humancomputerintegration/electrotactile-thermal-illusion/Hardware design/PCB.kicad_pcb

## KiCad design Hardware design/PCB.kicad_pcb (2026-09-23)

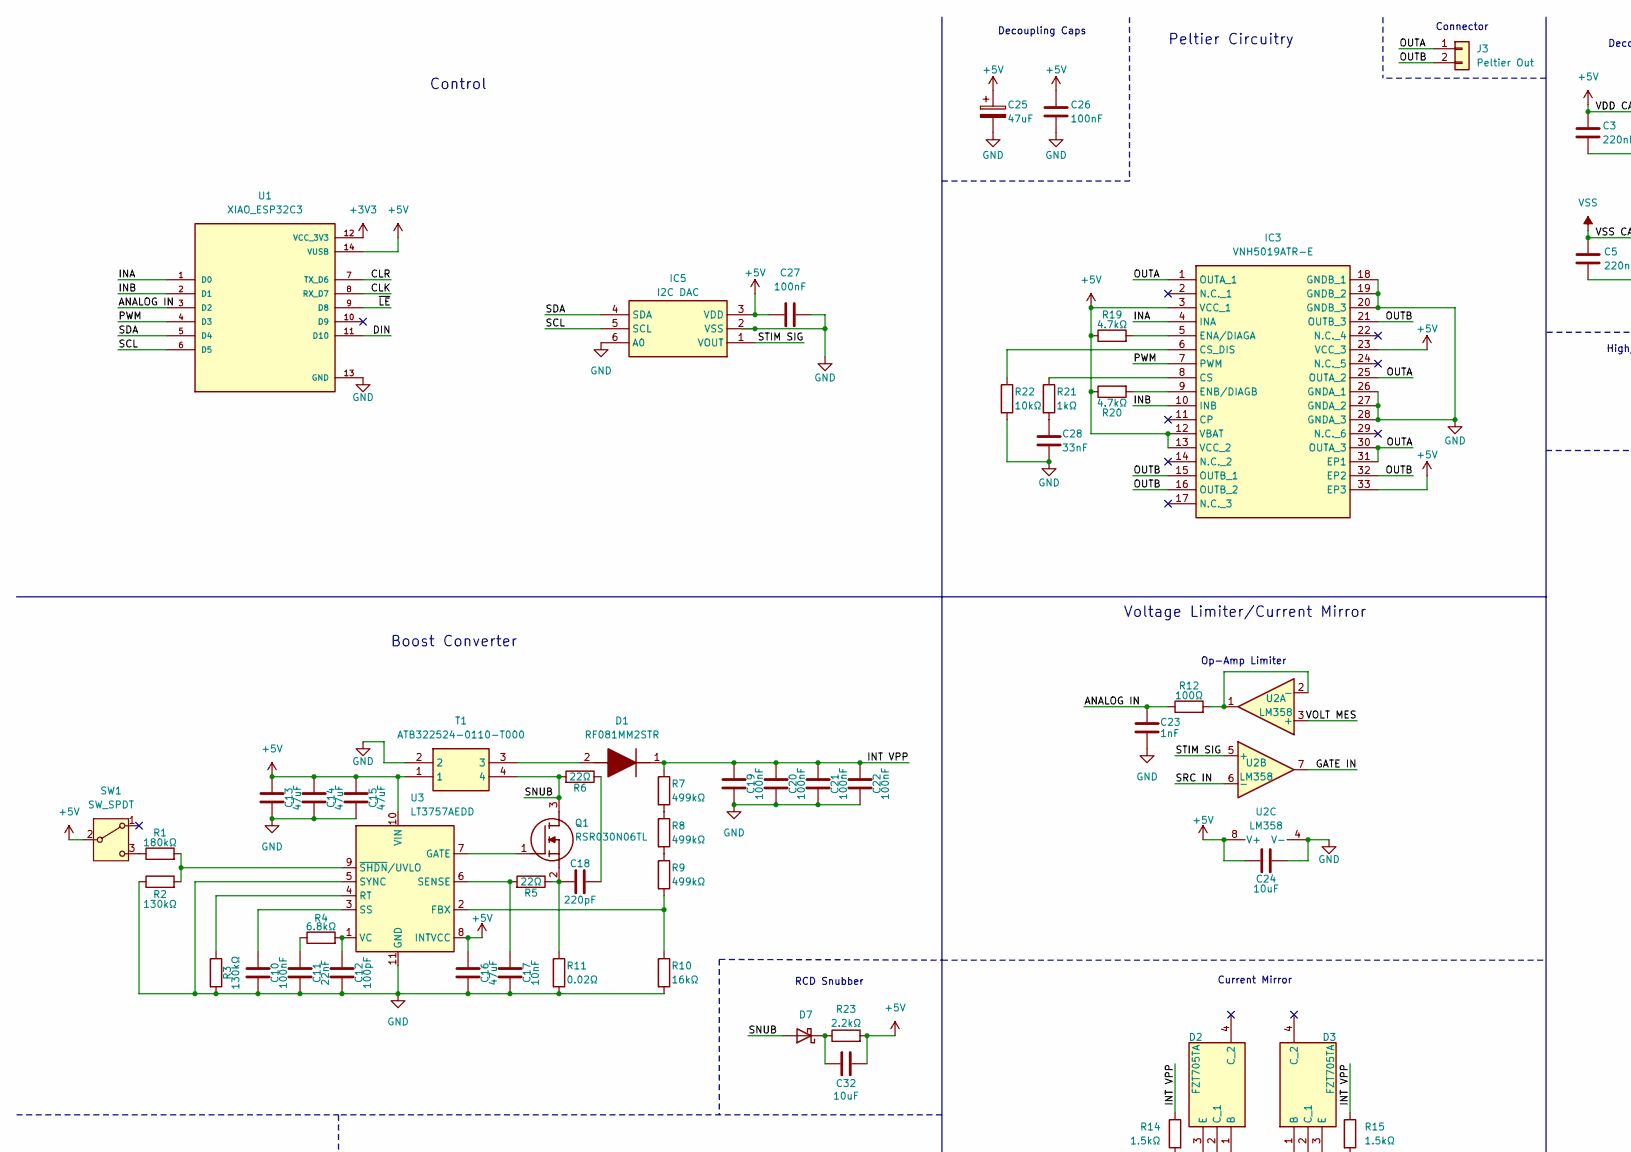
[picture p1: schematic PCB.kicad_sch, part in row 1, column 1]

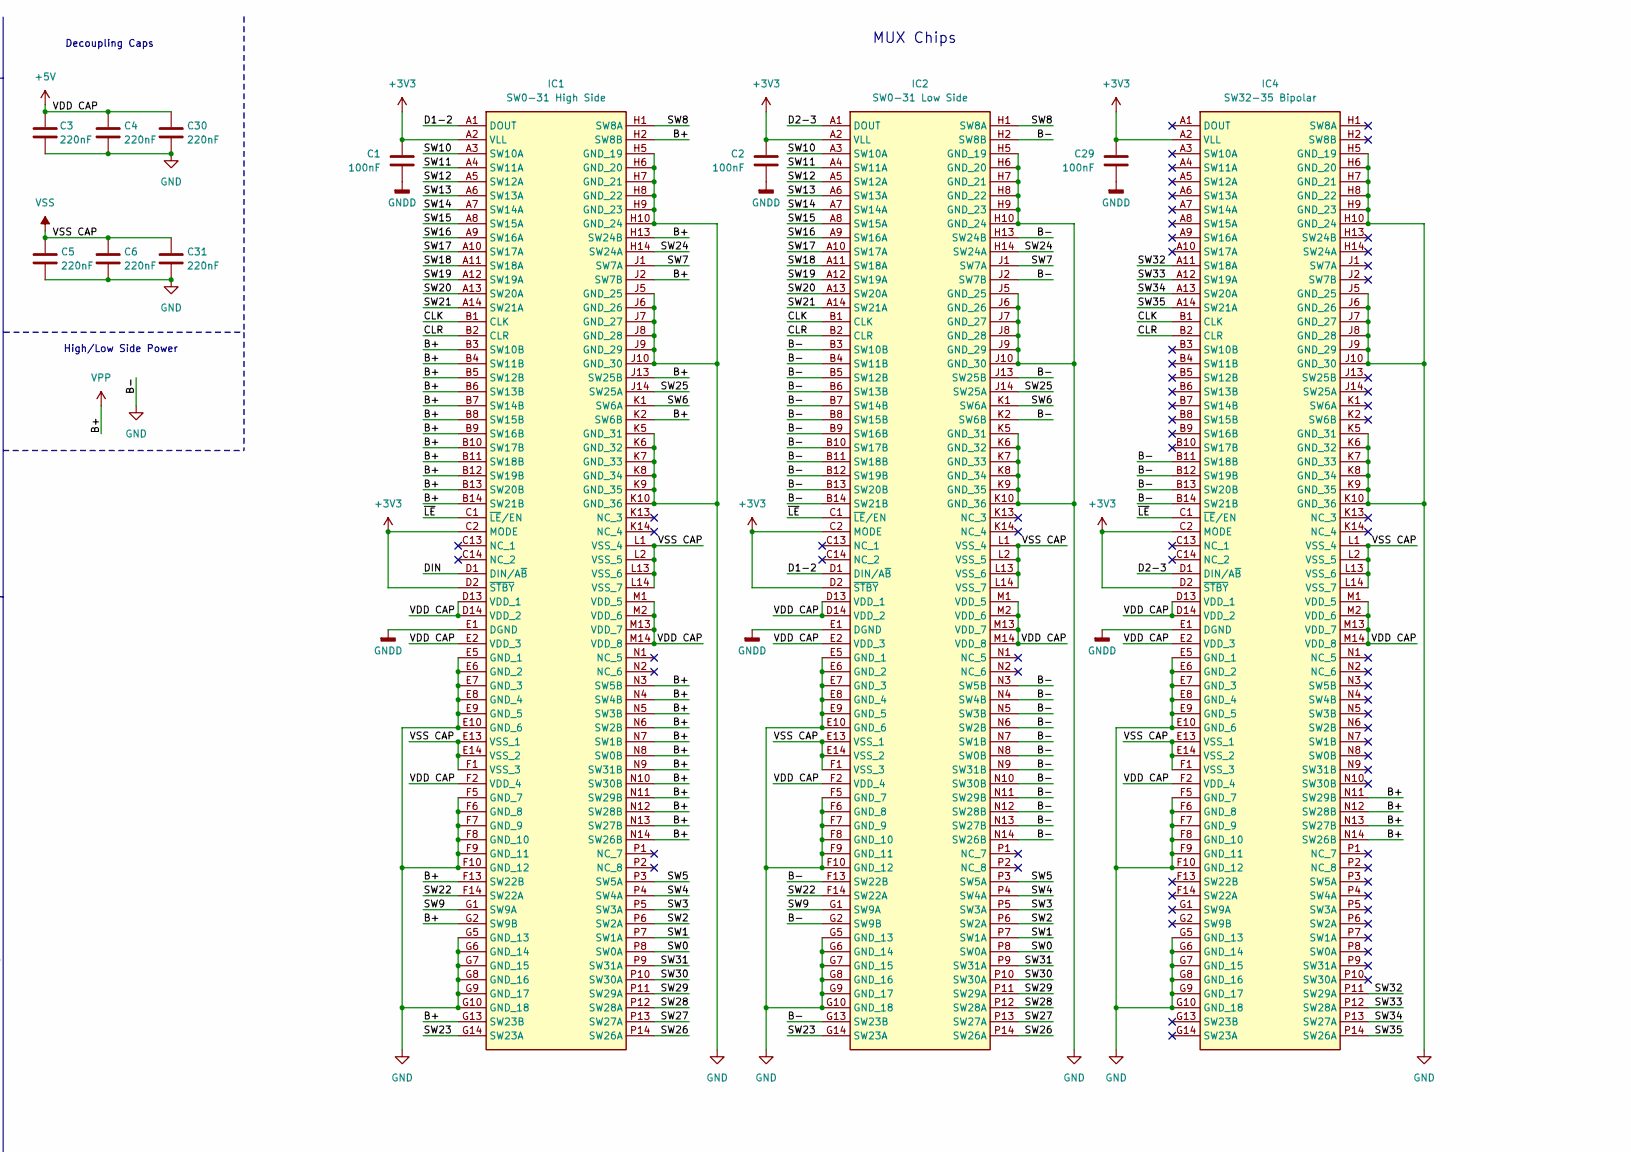
[picture p2: schematic PCB.kicad_sch, part in row 1, column 2]

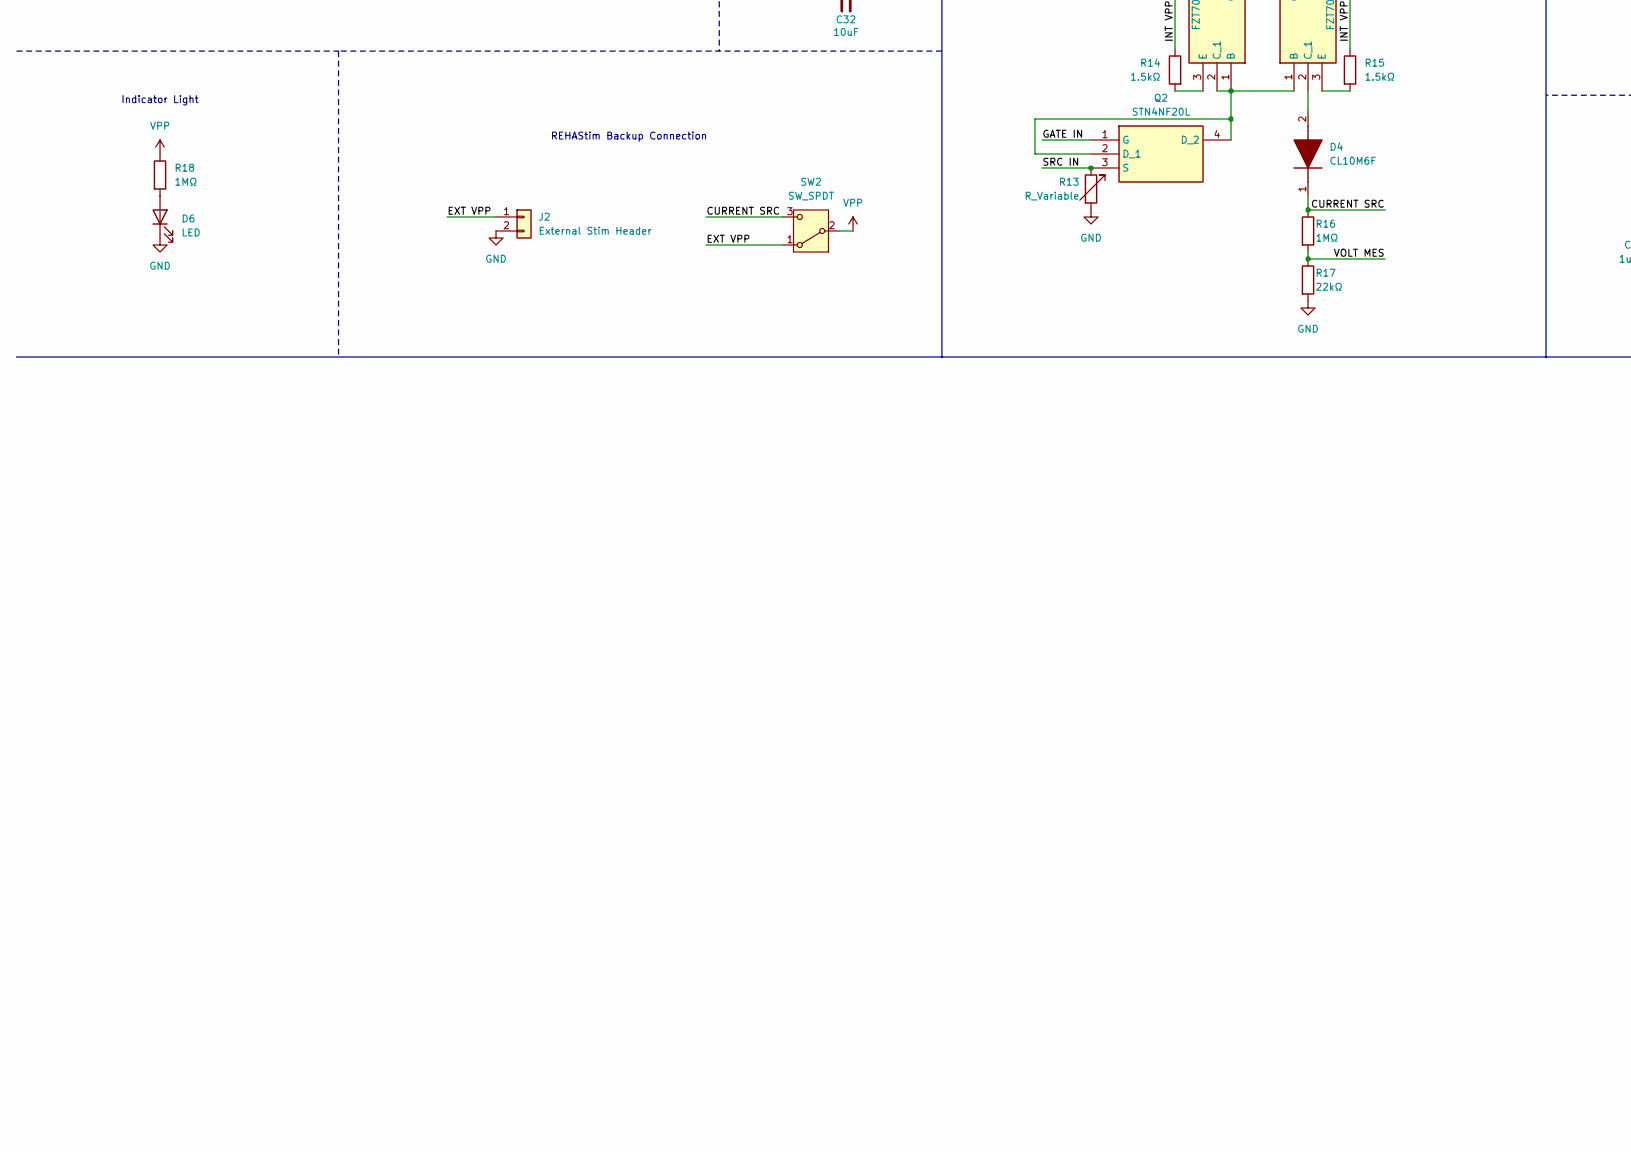
[picture p3: schematic PCB.kicad_sch, part in row 2, column 1]

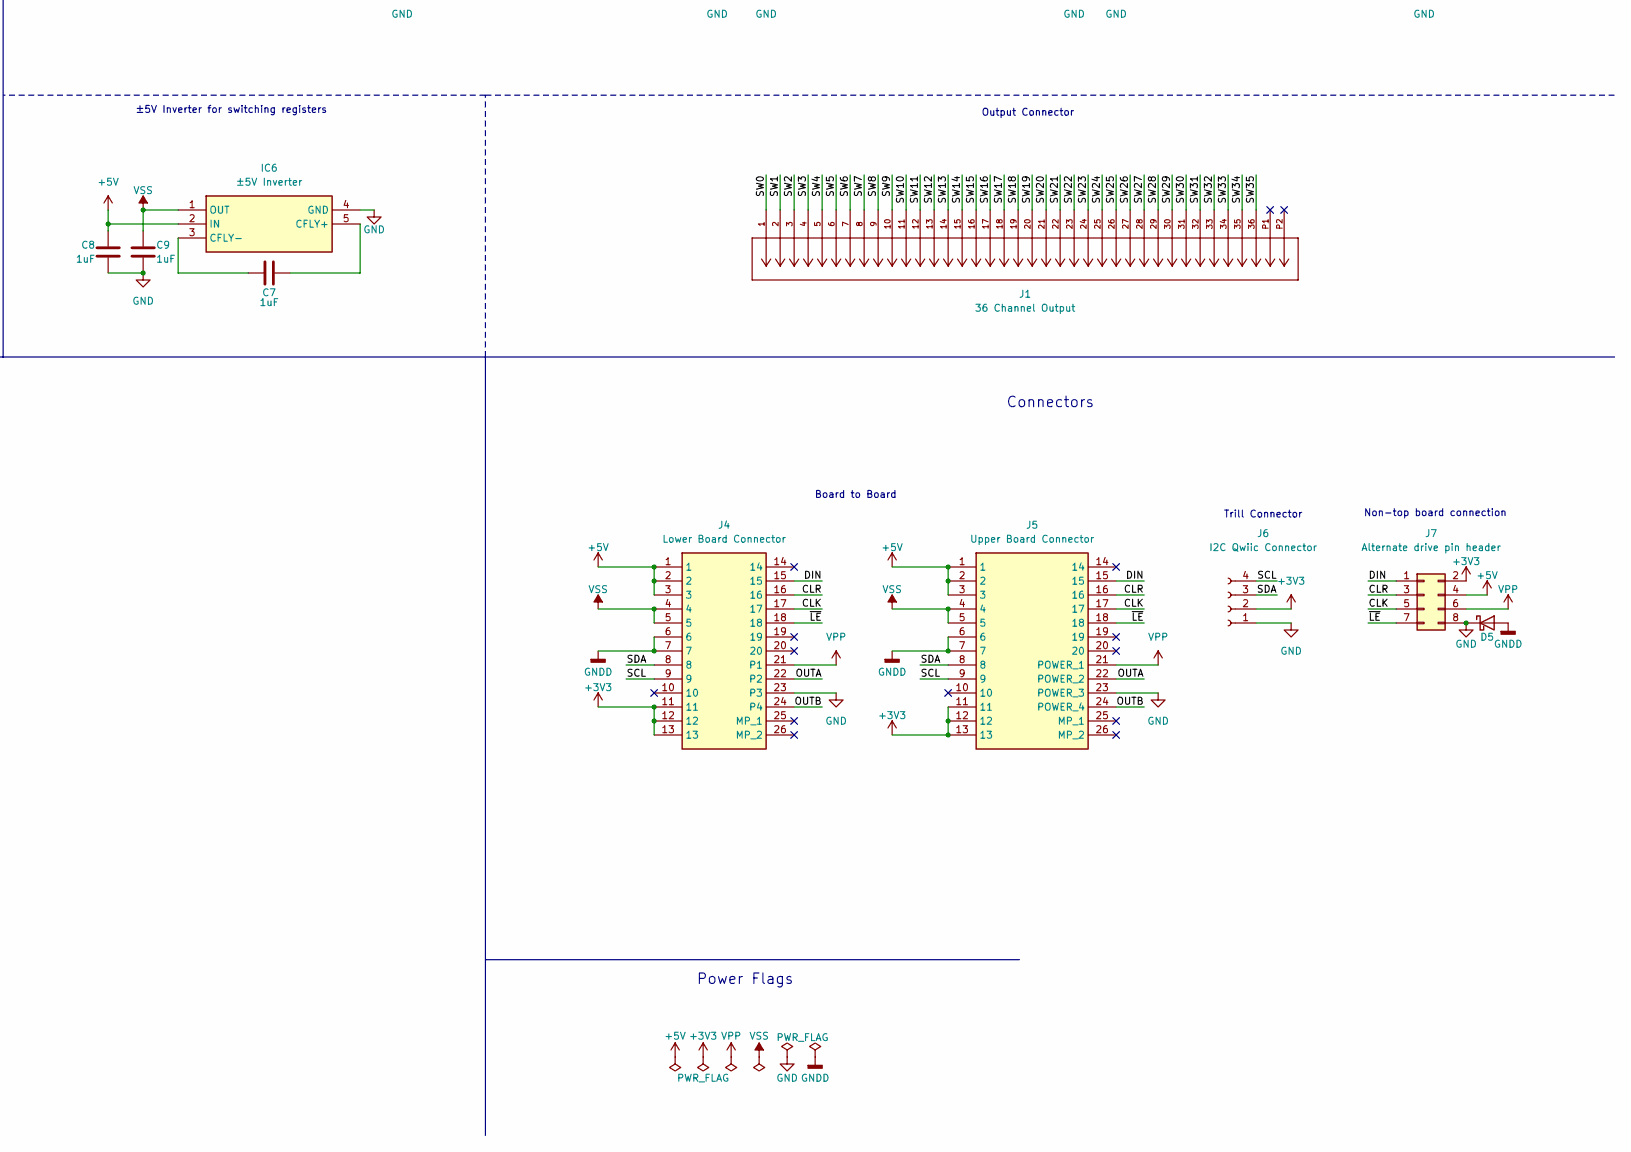
[picture p4: schematic PCB.kicad_sch, part in row 2, column 2]

Parts:
C1, C2, C10, C27, C29: 100nF; C_0402_1005Metric
C3, C4, C5, C6, C30, C31: 220nF; C_0402_1005Metric
C7, C8, C9: 1uF; C_0402_1005Metric
C11: 22nF; C_0402_1005Metric
C12: 100pF; C_0402_1005Metric
C13, C14, C15, C16: 47uF; C_1206_3216Metric
C17: 10nF; C_0402_1005Metric
C18: 220pF; C_0402_1005Metric
C19, C20, C21, C22: 100nF; C_0805_2012Metric
C23: 1nF; C_0402_1005Metric
C24: 10uF; C_0805_2012Metric
C25: 47uF; CP_Elec_6.3x5.4
C26: 100nF; C_0603_1608Metric
C28: 33nF; C_0402_1005Metric
C32: 10uF; C_0603_1608Metric
D1: RF081MM2STR; Mouser Part Number 755-RF081MM2STR
D2, D3: FZT705TA; SOT230P700X170-4N; Mouser Part Number 522-FZT705TA
D4: CL10M6F; SODFL3718X130N; Mouser Part Number 637-CL05M6F
D5: GNDD Diode; D_0603_1608Metric
D6: LED; LED_0603_1608Metric
D7: D_0603_1608Metric
IC1: SW0-31 High Side; BGA132C80P14X14_1200X1200X120; Mouser Part Number 579-HV2803/AHA
IC2: SW0-31 Low Side; BGA132C80P14X14_1200X1200X120; Mouser Part Number 579-HV2803/AHA
IC3: VNH5019ATR-E; VNH5019A-E_1; Mouser Part Number 511-VNH5019ATR-E
IC4: SW32-35 Bipolar; BGA132C80P14X14_1200X1200X120; Mouser Part Number 579-HV2803/AHA
IC5: I2C DAC; SOT95P280X145-6N; Mouser Part Number 579-MCP4725A1T-E/CH
IC6: ±5V Inverter; SOT95P280X145-5N; Mouser Part Number 595-TPS60403DBVRG4
J1: 36 Channel Output; CON_5051103691_MOL; MANUFACTURER_PART_NUMBER 5051103691
J2: External Stim Header; PinHeader_1x02_P2.54mm_Vertical
J3: Peltier Out; Peltier Pads
J4: Lower Board Connector; B3241B7L111220E100; Manufacturer_Part_Number B3241B7L111220E100
J5: Upper Board Connector; B3291B7L111220E100; Manufacturer_Part_Number B3291B7L111220E100
J6: I2C Qwiic Connector; JST_SH_BM04B-SRSS-TB_1x04-1MP_P1.00mm_Vertical
J7: Alternate drive pin header; PinHeader_2x04_P2.54mm_Vertical
Q1: RSR030N06TL; SOTFL40P120X55-3N; Mouser Part Number 755-RSM002N06T2L
Q2: STN4NF20L; SOT230P700X190-4N; Mouser Part Number 511-STN4NF20L
R1: 180kΩ; R_0402_1005Metric
R2, R3: 130kΩ; R_0402_1005Metric
R4: 6.8kΩ; R_0402_1005Metric
R5, R6: 22Ω; R_0402_1005Metric
R7, R8, R9: 499kΩ; R_0402_1005Metric
R10: 16kΩ; R_0402_1005Metric
R11: 0.02Ω; R_0603_1608Metric
R12: 100Ω; R_0402_1005Metric
R13: R_Variable; Potentiometer_Bourns_3314J_Vertical
R14, R15: 1.5kΩ; R_0603_1608Metric
R16, R18: 1MΩ; R_0603_1608Metric
R17: 22kΩ; R_0603_1608Metric
R19, R20: 4.7kΩ; R_0402_1005Metric
R21: 1kΩ; R_0402_1005Metric
R22: 10kΩ; R_0402_1005Metric
R23: 2.2kΩ; R_0603_1608Metric
SW1, SW2: SW_SPDT; SW_SPDT_PCM12
T1: ATB322524-0110-T000; CHOKE_524-0110-T000_TDK-M
U1: XIAO_ESP32C3; XIAO-ESP32-C3-SMD; PARTREV 23/05/2022
U2: LM358; VSSOP-8_3x3mm_P0.65mm
U3: LT3757AEDD; DFN-10-1EP_3x3mm_P0.5mm_EP1.55x2.48mm

Connections:
+3V3: C1.1, C2.1, C29.1, IC1.A2 (VLL), IC1.C2 (MODE), IC1.D2 (~STBY), IC2.A2 (VLL), IC2.C2 (MODE), IC2.D2 (~STBY), IC4.A2 (VLL), IC4.C2 (MODE), IC4.D2 (~STBY), J4.11, J4.12, J4.13, J5.11, J5.12, J5.13, J6.2, J7.2, U1.12 (VCC_3V3)
+5V: C3.1, C4.1, C8.1, C13.1, C14.1, C15.1, C16.1, C24.1, C25.1, C26.1, C27.1, C30.1, C32.2, IC1.D13 (VDD_1), IC1.D14 (VDD_2), IC1.E2 (VDD_3), IC1.F2 (VDD_4), IC1.M1 (VDD_5), IC1.M2 (VDD_6), IC1.M13 (VDD_7), IC1.M14 (VDD_8), IC2.D13 (VDD_1), IC2.D14 (VDD_2), IC2.E2 (VDD_3), IC2.F2 (VDD_4), IC2.M1 (VDD_5), IC2.M2 (VDD_6), IC2.M13 (VDD_7), IC2.M14 (VDD_8), IC3.3 (VCC_1), IC3.12 (VBAT), IC3.13 (VCC_2), IC3.23 (VCC_3), IC3.33 (EP3), IC4.D13 (VDD_1), IC4.D14 (VDD_2), IC4.E2 (VDD_3), IC4.F2 (VDD_4), IC4.M1 (VDD_5), IC4.M2 (VDD_6), IC4.M13 (VDD_7), IC4.M14 (VDD_8), IC5.3 (VDD), IC6.2 (IN), J4.1, J4.2, J4.3, J5.1, J5.2, J5.3, J7.4, R19.1, R20.1, R23.2, SW1.2 (B), T1.1, U1.14 (VUSB), U2.8 (V+), U3.8 (INTVCC), U3.10 (VIN)
/ANALOG IN: C23.1, R12.1, U1.3 (D2)
/CLK: IC1.B1 (CLK), IC2.B1 (CLK), IC4.B1 (CLK), J4.17, J5.17, J7.5, U1.8 (RX_D7)
/CLR: IC1.B2 (CLR), IC2.B2 (CLR), IC4.B2 (CLR), J4.16, J5.16, J7.3, U1.7 (TX_D6)
/CURRENT SRC: D4.1 (K), R16.1, SW2.3 (C)
/D1-2: IC1.A1 (DOUT), IC2.D1 (DIN/A~B)
/D2-3: IC2.A1 (DOUT), IC4.D1 (DIN/A~B)
/DIN: IC1.D1 (DIN/A~B), J4.15, J5.15, J7.1, U1.11 (D10)
/EXT VPP: J2.1, SW2.1 (A)
/GATE IN: Q2.1 (G), U2.7
/INA: IC3.4 (INA), U1.1 (D0)
/INB: IC3.10 (INB), U1.2 (D1)
/INT VPP: C19.1, C20.1, C21.1, C22.1, D1.1 (K), R7.1, R14.1, R15.1
/OUTA: IC3.1 (OUTA_1), IC3.25 (OUTA_2), IC3.30 (OUTA_3), IC3.31 (EP1), J3.1, J4.22 (P2), J5.22 (POWER_2)
/OUTB: IC3.15 (OUTB_1), IC3.16 (OUTB_2), IC3.21 (OUTB_3), IC3.32 (EP2), J3.2, J4.24 (P4), J5.24 (POWER_4)
/PWM: IC3.7 (PWM), U1.4 (D3)
/SCL: IC5.5 (SCL), J4.9, J5.9, J6.4, U1.6 (D5); also elsewhere on the board
/SDA: IC5.4 (SDA), J4.8, J5.8, J6.3, U1.5 (D4); also elsewhere on the board
/SRC IN: Q2.3 (S), R13.1, U2.6 (-)
/STIM SIG: IC5.1 (VOUT), U2.5 (+)
/SW0: IC1.P8 (SW0A), IC2.P8 (SW0A), J1.1
/SW1: IC1.P7 (SW1A), IC2.P7 (SW1A), J1.2
/SW2: IC1.P6 (SW2A), IC2.P6 (SW2A), J1.3
/SW3: IC1.P5 (SW3A), IC2.P5 (SW3A), J1.4
/SW4: IC1.P4 (SW4A), IC2.P4 (SW4A), J1.5
/SW5: IC1.P3 (SW5A), IC2.P3 (SW5A), J1.6
/SW6: IC1.K1 (SW6A), IC2.K1 (SW6A), J1.7
/SW7: IC1.J1 (SW7A), IC2.J1 (SW7A), J1.8
/SW8: IC1.H1 (SW8A), IC2.H1 (SW8A), J1.9
/SW9: IC1.G1 (SW9A), IC2.G1 (SW9A), J1.10
/SW10: IC1.A3 (SW10A), IC2.A3 (SW10A), J1.11
/SW11: IC1.A4 (SW11A), IC2.A4 (SW11A), J1.12
/SW12: IC1.A5 (SW12A), IC2.A5 (SW12A), J1.13
/SW13: IC1.A6 (SW13A), IC2.A6 (SW13A), J1.14
/SW14: IC1.A7 (SW14A), IC2.A7 (SW14A), J1.15
/SW15: IC1.A8 (SW15A), IC2.A8 (SW15A), J1.16
/SW16: IC1.A9 (SW16A), IC2.A9 (SW16A), J1.17
/SW17: IC1.A10 (SW17A), IC2.A10 (SW17A), J1.18
/SW18: IC1.A11 (SW18A), IC2.A11 (SW18A), J1.19
/SW19: IC1.A12 (SW19A), IC2.A12 (SW19A), J1.20
/SW20: IC1.A13 (SW20A), IC2.A13 (SW20A), J1.21
/SW21: IC1.A14 (SW21A), IC2.A14 (SW21A), J1.22
/SW22: IC1.F14 (SW22A), IC2.F14 (SW22A), J1.23
/SW23: IC1.G14 (SW23A), IC2.G14 (SW23A), J1.24
/SW24: IC1.H14 (SW24A), IC2.H14 (SW24A), J1.25
/SW25: IC1.J14 (SW25A), IC2.J14 (SW25A), J1.26
/SW26: IC1.P14 (SW26A), IC2.P14 (SW26A), J1.27
/SW27: IC1.P13 (SW27A), IC2.P13 (SW27A), J1.28
/SW28: IC1.P12 (SW28A), IC2.P12 (SW28A), J1.29
/SW29: IC1.P11 (SW29A), IC2.P11 (SW29A), J1.30
/SW30: IC1.P10 (SW30A), IC2.P10 (SW30A), J1.31
/SW31: IC1.P9 (SW31A), IC2.P9 (SW31A), J1.32
/SW32: IC4.A11 (SW18A), IC4.P11 (SW29A), J1.33
/SW33: IC4.A12 (SW19A), IC4.P12 (SW28A), J1.34
/SW34: IC4.A13 (SW20A), IC4.P13 (SW27A), J1.35
/SW35: IC4.A14 (SW21A), IC4.P14 (SW26A), J1.36
/VOLT MES: R16.2, R17.1, U2.3 (+)
/~LE: IC1.C1 (~LE/EN), IC2.C1 (~LE/EN), IC4.C1 (~LE/EN), J4.18, J5.18, J7.7, U1.9 (D8)
GND: C3.2, C4.2, C5.2, C6.2, C8.2, C9.2, C10.2, C11.2, C12.2, C13.2, C14.2, C15.2, C16.2, C17.2, C19.2, C20.2, C21.2, C22.2, C23.2, C24.2, C25.2, C26.2, C27.2, C28.2, C30.2, C31.2, D5.1 (K), D6.1 (K), IC1.E5 (GND_1), IC1.E6 (GND_2), IC1.E7 (GND_3), IC1.E8 (GND_4), IC1.E9 (GND_5), IC1.E10 (GND_6), IC1.F5 (GND_7), IC1.F6 (GND_8), IC1.F7 (GND_9), IC1.F8 (GND_10), IC1.F9 (GND_11), IC1.F10 (GND_12), IC1.G5 (GND_13), IC1.G6 (GND_14), IC1.G7 (GND_15), IC1.G8 (GND_16), IC1.G9 (GND_17), IC1.G10 (GND_18), IC1.H5 (GND_19), IC1.H6 (GND_20), IC1.H7 (GND_21), IC1.H8 (GND_22), IC1.H9 (GND_23), IC1.H10 (GND_24), IC1.J5 (GND_25), IC1.J6 (GND_26), IC1.J7 (GND_27), IC1.J8 (GND_28), IC1.J9 (GND_29), IC1.J10 (GND_30), IC1.K5 (GND_31), IC1.K6 (GND_32), IC1.K7 (GND_33), IC1.K8 (GND_34), IC1.K9 (GND_35), IC1.K10 (GND_36), IC2.B3 (SW10B), IC2.B4 (SW11B), IC2.B5 (SW12B), IC2.B6 (SW13B), IC2.B7 (SW14B), IC2.B8 (SW15B), IC2.B9 (SW16B), IC2.B10 (SW17B), IC2.B11 (SW18B), IC2.B12 (SW19B), IC2.B13 (SW20B), IC2.B14 (SW21B), IC2.E5 (GND_1), IC2.E6 (GND_2), IC2.E7 (GND_3), IC2.E8 (GND_4), IC2.E9 (GND_5), IC2.E10 (GND_6), IC2.F5 (GND_7), IC2.F6 (GND_8), IC2.F7 (GND_9), IC2.F8 (GND_10), IC2.F9 (GND_11), IC2.F10 (GND_12), IC2.F13 (SW22B), IC2.G2 (SW9B), IC2.G5 (GND_13), IC2.G6 (GND_14), IC2.G7 (GND_15), IC2.G8 (GND_16), IC2.G9 (GND_17), IC2.G10 (GND_18), IC2.G13 (SW23B), IC2.H2 (SW8B), IC2.H5 (GND_19), IC2.H6 (GND_20), IC2.H7 (GND_21), IC2.H8 (GND_22), IC2.H9 (GND_23), IC2.H10 (GND_24), IC2.H13 (SW24B), IC2.J2 (SW7B), IC2.J5 (GND_25), IC2.J6 (GND_26), IC2.J7 (GND_27), IC2.J8 (GND_28), IC2.J9 (GND_29), IC2.J10 (GND_30), IC2.J13 (SW25B), IC2.K2 (SW6B), IC2.K5 (GND_31), IC2.K6 (GND_32), IC2.K7 (GND_33), IC2.K8 (GND_34), IC2.K9 (GND_35), IC2.K10 (GND_36), IC2.N3 (SW5B), IC2.N4 (SW4B), IC2.N5 (SW3B), IC2.N6 (SW2B), IC2.N7 (SW1B), IC2.N8 (SW0B), IC2.N9 (SW31B), IC2.N10 (SW30B), IC2.N11 (SW29B), IC2.N12 (SW28B), IC2.N13 (SW27B), IC2.N14 (SW26B), IC3.18 (GNDB_1), IC3.19 (GNDB_2), IC3.20 (GNDB_3), IC3.26 (GNDA_1), IC3.27 (GNDA_2), IC3.28 (GNDA_3), IC4.B11 (SW18B), IC4.B12 (SW19B), IC4.B13 (SW20B), IC4.B14 (SW21B), IC4.E5 (GND_1), IC4.E6 (GND_2), IC4.E7 (GND_3), IC4.E8 (GND_4), IC4.E9 (GND_5), IC4.E10 (GND_6), IC4.F5 (GND_7), IC4.F6 (GND_8), IC4.F7 (GND_9), IC4.F8 (GND_10), IC4.F9 (GND_11), IC4.F10 (GND_12), IC4.G5 (GND_13), IC4.G6 (GND_14), IC4.G7 (GND_15), IC4.G8 (GND_16), IC4.G9 (GND_17), IC4.G10 (GND_18), IC4.H5 (GND_19), IC4.H6 (GND_20), IC4.H7 (GND_21), IC4.H8 (GND_22), IC4.H9 (GND_23), IC4.H10 (GND_24), IC4.J5 (GND_25), IC4.J6 (GND_26), IC4.J7 (GND_27), IC4.J8 (GND_28), IC4.J9 (GND_29), IC4.J10 (GND_30), IC4.K5 (GND_31), IC4.K6 (GND_32), IC4.K7 (GND_33), IC4.K8 (GND_34), IC4.K9 (GND_35), IC4.K10 (GND_36), IC5.2 (VSS), IC5.6 (A0), IC6.4 (GND), J2.2, J4.23 (P3), J5.23 (POWER_3), J6.1, J7.8, R2.1, R3.2, R10.2, R11.2, R13.2, R17.2, R22.2, T1.2, U1.13 (GND), U2.4 (V-), U3.5 (SYNC), U3.11 (GND); also elsewhere on the board
GNDD: C1.2, C2.2, C29.2, D5.2 (A), IC1.E1 (DGND), IC2.E1 (DGND), IC4.E1 (DGND), J4.6, J4.7, J5.6, J5.7
unnamed: C11.1, R4.1
unnamed: C18.2, R6.1
unnamed: C28.1, R21.2
unnamed: D1.2 (A), T1.3
unnamed: D2.1 (B), D2.2 (C_1), D3.1 (B), Q2.2 (D_1), Q2.4 (D_2)
unnamed: D2.3 (E), R14.2
unnamed: D3.2 (C_1), D4.2 (A)
unnamed: D3.3 (E), R15.2
unnamed: D6.2 (A), R18.2
unnamed: C32.1, D7.1 (K), R23.1
unnamed: IC3.8 (CS), R21.1
unnamed: IC3.6 (CS_DIS), R22.1
unnamed: IC3.5 (ENA/DIAGA), R19.2
unnamed: IC3.9 (ENB/DIAGB), R20.2
unnamed: C7.1, IC6.5 (CFLY+)
unnamed: C7.2, IC6.3 (CFLY-)
unnamed: Q1.1 (G), U3.7 (GATE)
unnamed: C18.1, Q1.2 (S), R5.1, R11.1
unnamed: R7.2, R8.1
unnamed: R8.2, R9.1
unnamed: R1.1, SW1.3 (C)
unnamed: R12.2, U2.1, U2.2 (-)
unnamed: R9.2, R10.1, U3.2 (FBX)
unnamed: R3.1, U3.4 (RT)
unnamed: C17.1, R5.2, U3.6 (SENSE)
unnamed: C10.1, U3.3 (SS)
unnamed: C12.1, R4.2, U3.1 (VC)
unnamed: R1.2, R2.2, U3.9 (~SHDN/UVLO)
VPP: IC1.B3 (SW10B), IC1.B4 (SW11B), IC1.B5 (SW12B), IC1.B6 (SW13B), IC1.B7 (SW14B), IC1.B8 (SW15B), IC1.B9 (SW16B), IC1.B10 (SW17B), IC1.B11 (SW18B), IC1.B12 (SW19B), IC1.B13 (SW20B), IC1.B14 (SW21B), IC1.F13 (SW22B), IC1.G2 (SW9B), IC1.G13 (SW23B), IC1.H2 (SW8B), IC1.H13 (SW24B), IC1.J2 (SW7B), IC1.J13 (SW25B), IC1.K2 (SW6B), IC1.N3 (SW5B), IC1.N4 (SW4B), IC1.N5 (SW3B), IC1.N6 (SW2B), IC1.N7 (SW1B), IC1.N8 (SW0B), IC1.N9 (SW31B), IC1.N10 (SW30B), IC1.N11 (SW29B), IC1.N12 (SW28B), IC1.N13 (SW27B), IC1.N14 (SW26B), IC4.N11 (SW29B), IC4.N12 (SW28B), IC4.N13 (SW27B), IC4.N14 (SW26B), J4.21 (P1), J5.21 (POWER_1), J7.6, R18.1, SW2.2 (B)
VSS: C5.1, C6.1, C9.1, C31.1, IC1.E13 (VSS_1), IC1.E14 (VSS_2), IC1.F1 (VSS_3), IC1.L1 (VSS_4), IC1.L2 (VSS_5), IC1.L13 (VSS_6), IC1.L14 (VSS_7), IC2.E13 (VSS_1), IC2.E14 (VSS_2), IC2.F1 (VSS_3), IC2.L1 (VSS_4), IC2.L2 (VSS_5), IC2.L13 (VSS_6), IC2.L14 (VSS_7), IC4.E13 (VSS_1), IC4.E14 (VSS_2), IC4.F1 (VSS_3), IC4.L1 (VSS_4), IC4.L2 (VSS_5), IC4.L13 (VSS_6), IC4.L14 (VSS_7), IC6.1 (OUT), J4.4, J4.5, J5.4, J5.5; also elsewhere on the board

Notes on the sheet:
Op-Amp Limiter
Current Mirror
Output Connector
Trill Connector
Connectors
Voltage Limiter/Current Mirror
Decoupling Caps
MUX Chips
±5V Inverter for switching registers
High/Low Side Power
Power Flags
Peltier Circuitry
Boost Converter
RCD Snubber
Control
Connector
Board to Board
Non-top board connection
REHAStim Backup Connection
Indicator Light

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
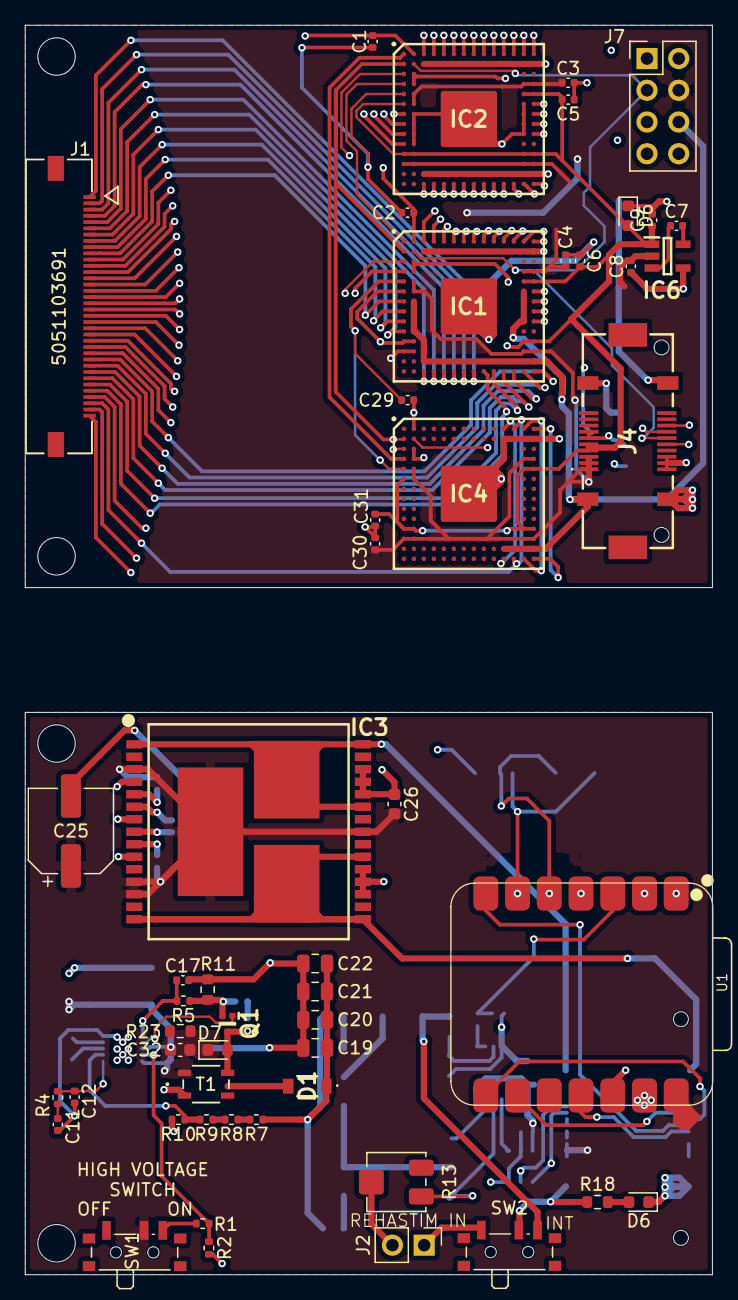
[picture p5: board PCB.kicad_pcb from above]

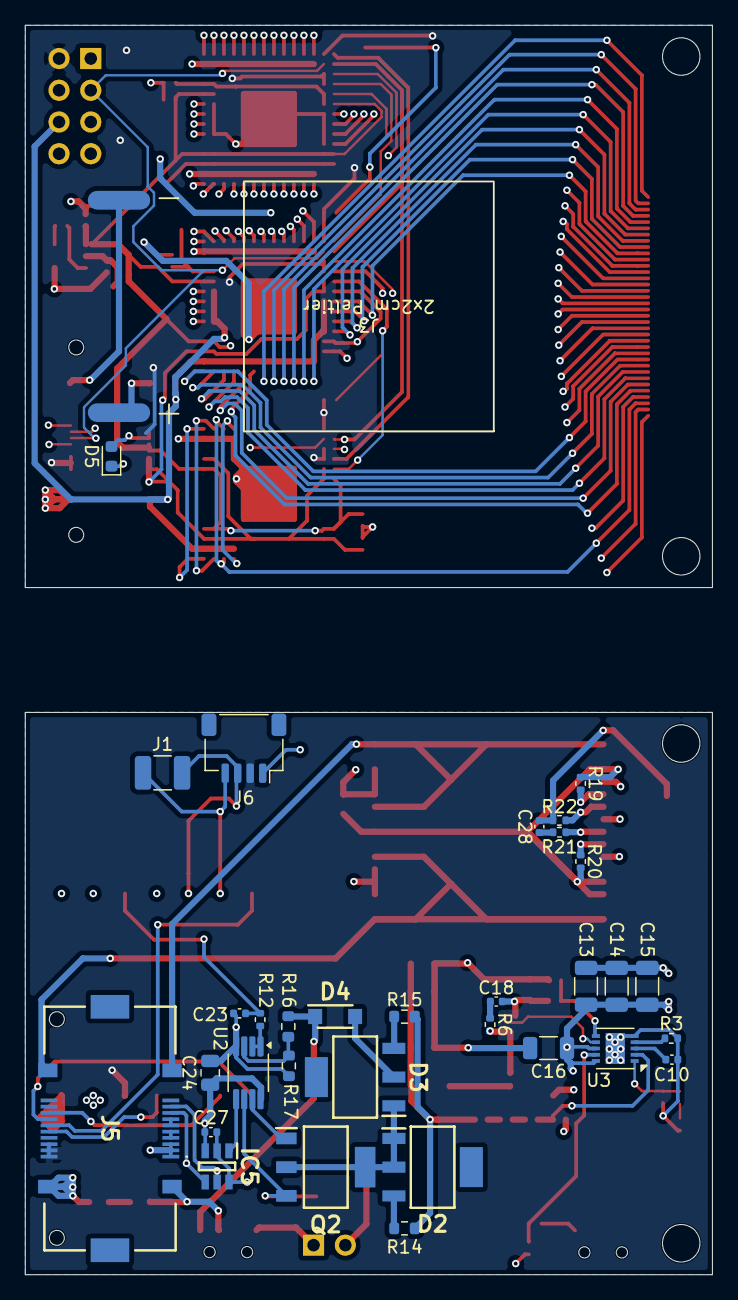
[picture p6: board PCB.kicad_pcb from below]

Board: 4 copper layers, 55.0 x 100.0 mm, 87 parts (33 on the bottom side), 92 nets.

Other parts of the board:
D6#2: VSS Diode; D_0603_1608Metric
J1#2: I2C Pads; C_1210_3225Metric_Pad1.33x2.70mm_HandSolder
J**: Support NPTH
J**#2: Support NPTH

Their connections:
/SCL: J1#2.1; also elsewhere on the board
/SDA: J1#2.2; also elsewhere on the board
GND: D6#2.1 (K); also elsewhere on the board
VSS: D6#2.2 (A); also elsewhere on the board
